Patil-Vinay/AgriDoc-Farm-Robot/docs/images/sim_gazebo_aisle.png

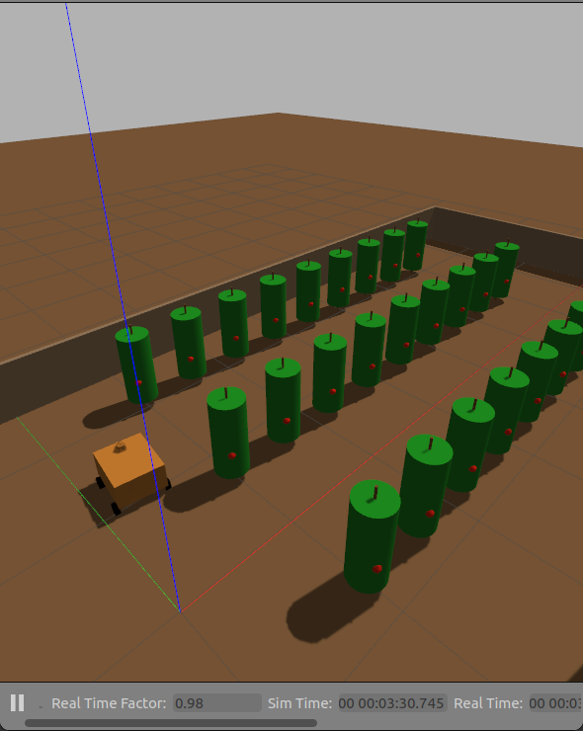
docs/images/sim_gazebo_aisle.png
