Patil-Vinay/AgriDoc-Farm-Robot/docs/images/sim_rviz_back_home.png

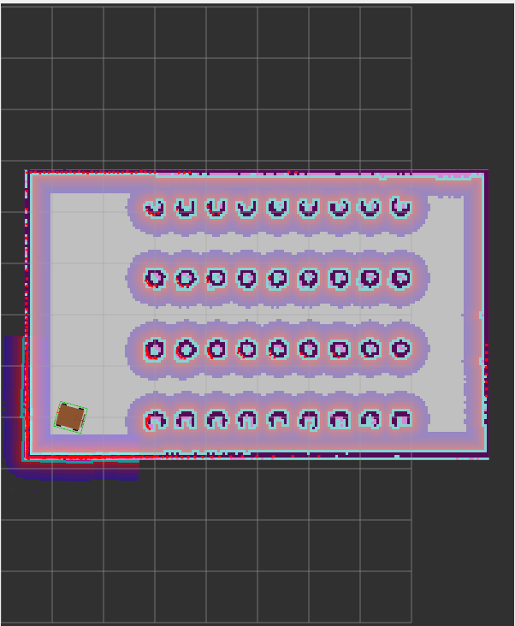
docs/images/sim_rviz_back_home.png
