Patil-Vinay/AgriDoc-Farm-Robot/cad/agridoc_robot.step

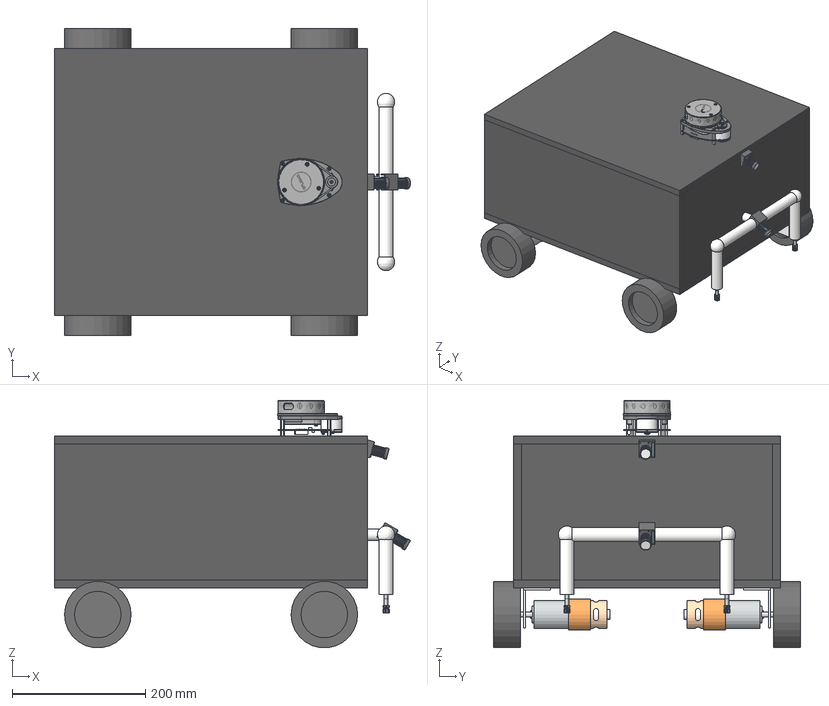
[picture p32: CAD file, 2022-10-15]
cad/agridoc_robot.step
534.3 x 460.0 x 371.2 mm
DC Mega torque motor x 2
WMN_106 x 2
WMN_103 x 2
WMN_105 x 2
WMN_104 x 2
WMN_102 x 2
WMN_101 x 2
Tank
Angle Bracket 2020 Aluminium Profile Joiner x 8
base
head-base
detector-mount
detector
laser
laser-mount
head
Woodscrews_GB_TYPE136 M2X6-N x 5
motherboard
connector-1_25-3pin
motor
motor-board
connector-1_25-4pin
bottom-lid
stand_15x2 x 4
stand-8x2 x 4
connector-7pin-2_5
devboard
rubber
wheel
