Patil-Vinay/AgriDoc-Farm-Robot/part1_autonomous_robot/agridoc_ws/src/agridoc_description/meshes/motors.stl

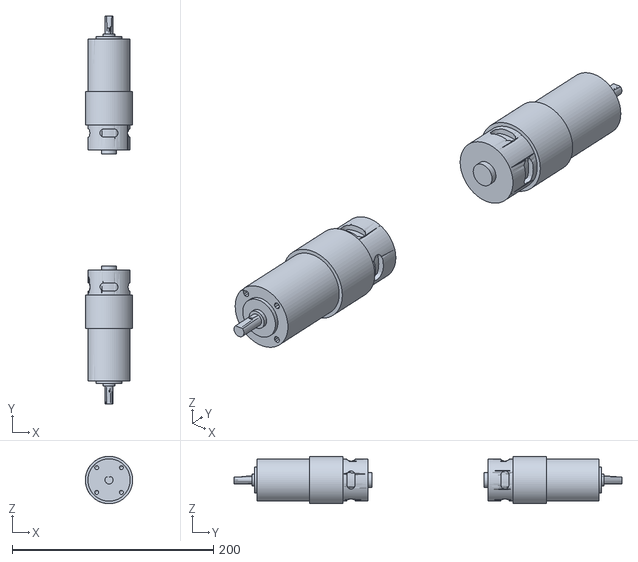
[picture p33: CAD file, 2022-08-13]
part1_autonomous_robot/agridoc_ws/src/agridoc_description/meshes/motors.stl
47.1 x 385.5 x 47.0
