Patil-Vinay/AgriDoc-Farm-Robot/part1_autonomous_robot/agridoc_ws/src/agridoc_description/meshes/lidar.stl

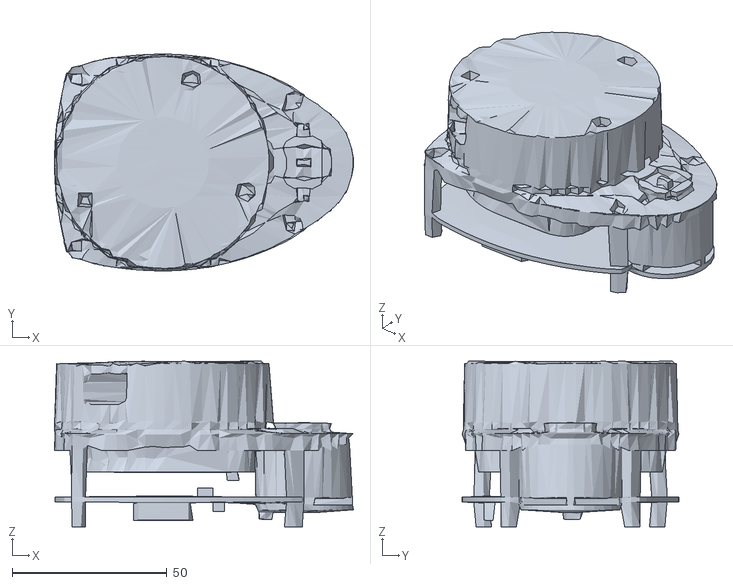
[picture p34: CAD file, 2022-08-13]
part1_autonomous_robot/agridoc_ws/src/agridoc_description/meshes/lidar.stl
96.6 x 70.0 x 53.5
