Patil-Vinay/AgriDoc-Farm-Robot/part1_autonomous_robot/agridoc_ws/src/agridoc_description/meshes/wheel.stl

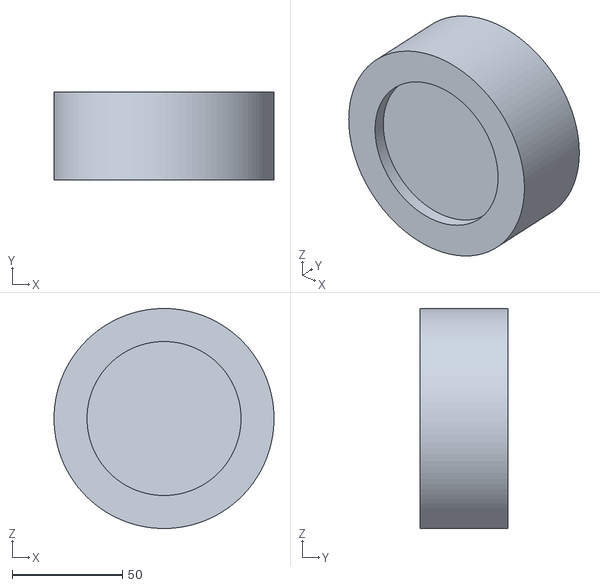
[picture p35: CAD file, 2022-08-13]
part1_autonomous_robot/agridoc_ws/src/agridoc_description/meshes/wheel.stl
100.0 x 40.0 x 100.0
