Patil-Vinay/AgriDoc-Farm-Robot/part1_autonomous_robot/agridoc_ws/src/agridoc_description/meshes/box.stl

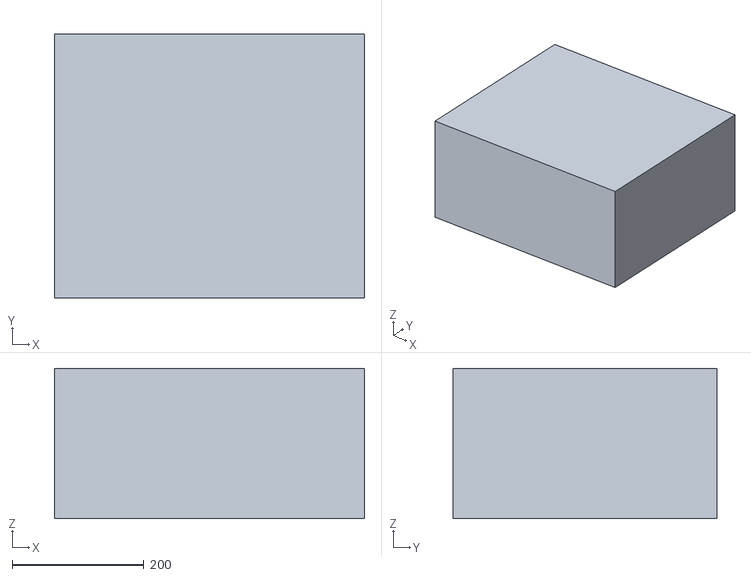
[picture p36: CAD file, 2022-08-13]
part1_autonomous_robot/agridoc_ws/src/agridoc_description/meshes/box.stl
470.0 x 400.0 x 228.0
