Patil-Vinay/AgriDoc-Farm-Robot/part1_autonomous_robot/agridoc_ws/src/agridoc_description/meshes/tank.stl

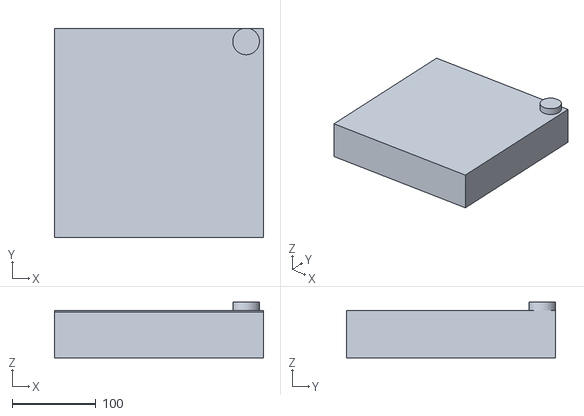
[picture p37: CAD file, 2022-08-13]
part1_autonomous_robot/agridoc_ws/src/agridoc_description/meshes/tank.stl
250.1 x 250.4 x 67.0
