Patil-Vinay/AgriDoc-Farm-Robot/(commit log)

2022-08-13 Add robot description and tomato field world
    [agridoc.gazebo.xacro, agridoc.urdf.xacro, box.stl, brackets.stl, disease_camera.stl, electronics.stl, lidar.stl, model.sdf]
2022-09-04 Add IMU, GPS and EKF to the simulation
    [agridoc.gazebo.xacro, agridoc.urdf.xacro]
2022-09-10 Add Jetson Nano image classification notes and script
2022-10-01 Add Arduino Mega firmware and serial bridge
2022-10-15 Add robot bringup, CAD model and docs
    [agridoc.urdf.xacro, agridoc_robot.step]
